han-xudong/metaball/(commit log)

2025-07-14 new file: .gitignore new file: LICENSE new file: README.md new file: config/training.yaml new file: docs/guide.ipynb new file: metaball/devices/camera/usbcamera.py new file: metaball/devices/camera/w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
2025-07-14 modified: README.md deleted: config/training.yaml new file: docs/deployment.md new file: metaball/config/__init__.py new file: metaball/config/ballnet_cfg.py new file: metaball/config/camera_cfg.py n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
2025-07-14 renamed: scripts/calibrate_camera/calib2yaml.m -> scripts/calib2yaml.m renamed: scripts/calibrate_camera/calibrate_camera.py -> scripts/calibrate_camera.py renamed: scripts/export_model/export_hef.py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
2025-07-15 modified: README.md new file: docs/assembly.md new file: docs/assets/banner.jpg new file: docs/assets/screenshot.jpg renamed: docs/guide.ipynb -> docs/training.ipynb modified: scripts/run_metaball.py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
2025-07-15 modified: README.md new file: configs_example/camera.yaml new file: configs_example/metaball.yaml new file: configs_example/training.yaml modified: docs/assembly.md new file: docs/assets/assembly.jpg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
    [led_board.epro, power_board_24v.epro]
2025-07-15 modified: docs/assembly.md
2025-07-16 modified: README.md modified: metaball/devices/camera/webcamera.py modified: metaball/models/onnx/ballnet.py modified: metaball/models/torch/ballnet.py modified: metaball/models/torch/datamodule.py m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
2026-01-08 Refactor project structure and configuration management
    - Removed the `train.py` script and integrated training logic into a new structured configuration system.
    - Introduced new configuration classes for camera, deploy, and training parameters using dataclasses.
    - Added a new `deploy.py` script for deployment with command-line interface support.
    - Implemented a new training script with enhanced logging and checkpointing features.
    - Updated the `setup.py` to include protobuf compilation during the build process.
    - Cleaned up unused files and organized the directory structure for better maintainability.
2026-01-08 Remove camera configuration module
2026-01-12 Update camera configuration, model paths, and refactor BallNet integration
    - Changed camera host IP in maixcam-xxxx.yaml from "192.168.31.116" to "10.114.202.1".
    - Refactored BallNet model initialization in training.ipynb to directly use the ONNX path.
    - Updated transfer vector and rotation matrix types in camera.py for better clarity.
    - Changed ONNX model path in deploy.py from "NeckNet.onnx" to "BallNet.onnx".
    - Modified WebCamera class in webcamera.py to use updated transfer vectors and matrices.
    - Simplified camera initialization in metaball.py to directly pass camera configuration.
    - Updated BallNet class in ballnet.py to print the ONNX model path during initialization.
    - Refactored ini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
2026-01-13 Update assembly image in documentation assets
2026-01-13 Update assembly image width in README for better visibility
2026-01-13 Update training documentation with hyperparameters and training options
    - Revised the section on model hyperparameters in `docs/training.ipynb` to include detailed descriptions and default values.
    - Added a table summarizing configurable options for the training script, including batch size, learning rate, and model dimensions.
    - Updated the command for exporting the model to ONNX format to reflect changes in the argument from `--ckpt_path` to `--ckpt_dir`.
    [led_board.epro, power_board_24v.epro]
2026-01-13 Update links in README for training, assembly, and model resources
2026-01-13 modified: README.md modified: docs/assembly.md modified: docs/training.ipynb modified: metaball/__init__.py modified: metaball/cli/__init__.py modified: metaball/cli/run.py modified: metaball/configs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
2026-02-03 Update camera calibration script usage instructions and assembly guide for clarity
2026-03-02 Refactor camera configuration: Rename 'dist' to 'dist_coeff' across multiple files for consistency and clarity
