han-xudong/metaball/(notices)

Notices in the files:
README.md:
License: MIT
